justinladwig/Co2-Ampel/README.md

# Co2-Ampel

Ein Projekt von Dr. Dieter Bergmann, Justin Ladwig, Nico Meyer, Lars Wittenbrink, Maximilian Zopp.

Mit Unterstützung durch Dr. Meike Rix und Menze.
