justinladwig/Co2-Ampel/hardware/Kabelliste.pdf

Produkt | Bauteil | Pin | verbunden mit | Länge | Farbe
Kabel (0,6mm²) | Piezo | GND | GND links mitte | 4cm | schwarz
Kabel (0,6mm²) | Piezo | 3V | D7 | 8cm | weiß
Schrumpfschlauch | Piezo | | | 1cm | schwarz
Schrumpfschlauch | Piezo | | | 1cm | schwarz
Kabel (0,6mm²) | LED1 | 5V | VU | 7cm | rot
Kabel (0,6mm²) | LED1 | GND | GND links oben | 7cm | schwarz
Kabel (0,6mm²) | LED1 | DATA | D6 | 7cm | gelb
Kabel (0,6mm²) | LED2 | 5V | LED1 5V | 9cm | rot
Kabel (0,6mm²) | LED2 | GND | LED1 GND | 9cm | schwarz
Kabel (0,6mm²) | LED2 | DATA | LED1 DATA | 9cm | gelb
Kabel (0,6mm²) | Sensor | 3V | 3V rechts oben | 7cm | rot
Kabel (0,6mm²) | Sensor | GND | GND rechts oben | 7cm | schwarz
Kabel (0,6mm²) | Sensor | SCL | D1 | 7cm | gelb
Kabel (0,6mm²) | Sensor | SDA | D2 | 7cm | gelb
Kabel (0,6mm²) | Sensor | WAKE | D5 | 9cm | weiß
