justinladwig/Co2-Ampel/hardware/CO2 Melder - Preisliste.xlsx

Produkt | Shop | Info | Einzelpreis | Anzahl | Preis
AZDelivery 5 x NodeMCU Lua Lolin V3 (https://www.amazon.de/gp/product/B07Z69WT62/ref=ox_sc_act_title_1?smid=A1X7QLRQH87QA3&psc=1) | Amazon |  | 19.49 € | 2 | 38.98 €
Kuman 100pcs SK6812 (https://www.amazon.de/gp/product/B01M6WVCW3/ref=ox_sc_act_title_2?smid=A88IN2Y8YWCG3&psc=1) | Amazon |  | 21.99 € | 1 | 21.99 €
JOY-IT Breakout-Board CCS811 (https://www.pollin.de/p/joy-it-breakout-board-ccs811-zur-messung-der-luftreinheit-811051) | Pollin |  | 15.50 € | 10 | 155.00 €
Piezo-Schallwandler, Summer 3 V, 85 dB (https://www.pollin.de/p/piezo-schallwandler-summer-3-v-85-db-rm-5-08-piepsend-printmontage-390131) | Pollin |  | 0.44 € | 10 | 4.40 €
USB-Powerbank LogiLink PA0156, 2200 mAh (https://www.pollin.de/p/usb-powerbank-logilink-pa0156-2200-mah-1x-usb-port-schluesselanhaenger-272127) | Pollin |  | 1.99 € | 5 | 9.95 €
USB2.0 Kabel HAMA 176755, A/Micro-B, 0,2 m, 90° (https://www.pollin.de/p/usb2-0-kabel-hama-176755-a-micro-b-0-2-m-900-713578) | Pollin | nur für Powerbanks | 0.65 € | 5 | 3.25 €
Kabel für Netzteil (Nein) |  |  |  |  | 0.00 €
Acrylglas |  |  |  |  | 0.00 €
Schrauben |  |  |  |  | 0.00 €
Einschmelzmuttern |  |  |  |  | 0.00 €
 |  |  |  |  | 0.00 €
 |  |  |  |  | 0.00 €
 |  |  |  |  | 0.00 €
 |  |  |  |  | 0.00 €
 |  |  |  |  | 0.00 €
 |  |  |  |  | 0.00 €
 |  |  |  |  | 0.00 €
 |  |  |  |  | 0.00 €
 |  |  |  |  | 0.00 €
Ergebnis |  |  |  |  | 233.57 €
