justinladwig/Co2-Ampel/3D-Data/CO2 Case 80x80.stl

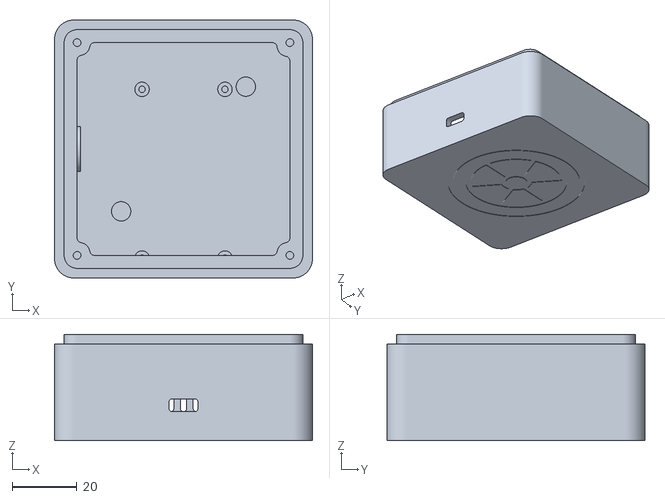
[picture p1: CAD file, 2020-12-04]
3D-Data/CO2 Case 80x80.stl
80.0 x 80.0 x 33.0
