justinladwig/Co2-Ampel/3D-Data/Gehaeuse 80x80 final 2.stl

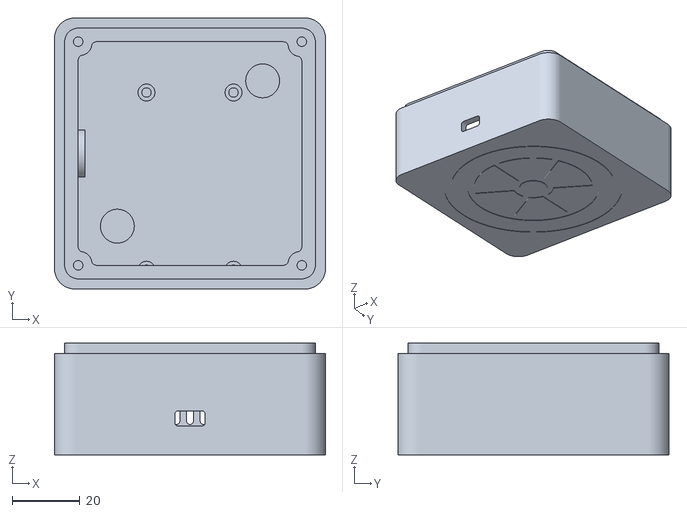
[picture p2: CAD file, 2020-12-04]
3D-Data/Gehaeuse 80x80 final 2.stl
80.0 x 80.0 x 33.0
