justinladwig/Co2-Ampel/3D-Data/Schrauben teststl.stl

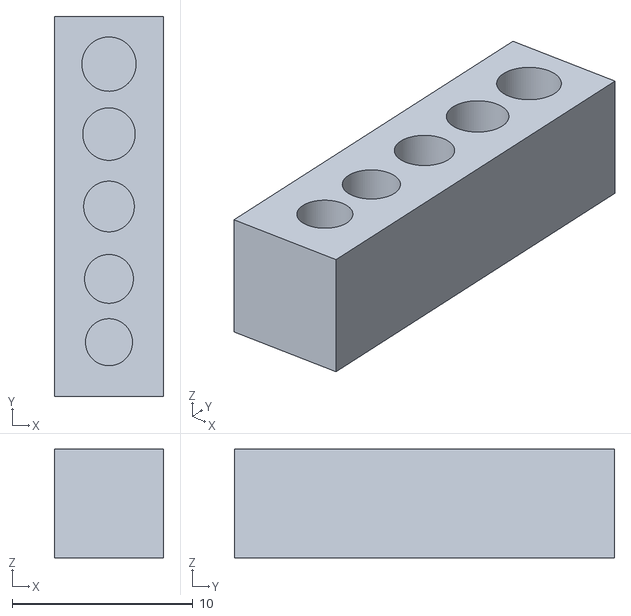
[picture p3: CAD file, 2020-12-04]
3D-Data/Schrauben teststl.stl
6.00 x 21.0 x 6.00
