justinladwig/Co2-Ampel/3D-Data/Plexi Glas Schablone 80x80.stl

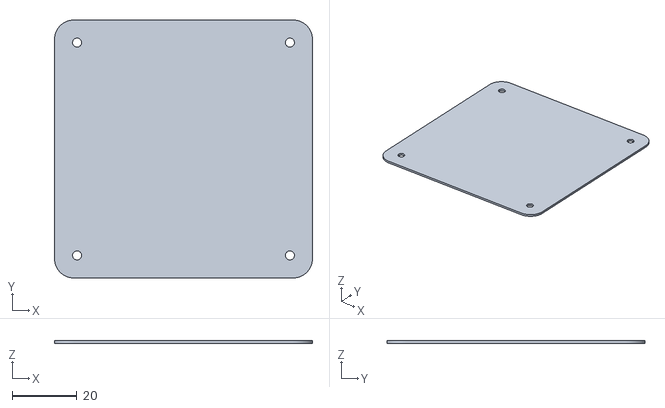
[picture p4: CAD file, 2020-12-04]
3D-Data/Plexi Glas Schablone 80x80.stl
80.0 x 80.0 x 0.8
