justinladwig/Co2-Ampel/3D-Data/Piezo Teststl.stl

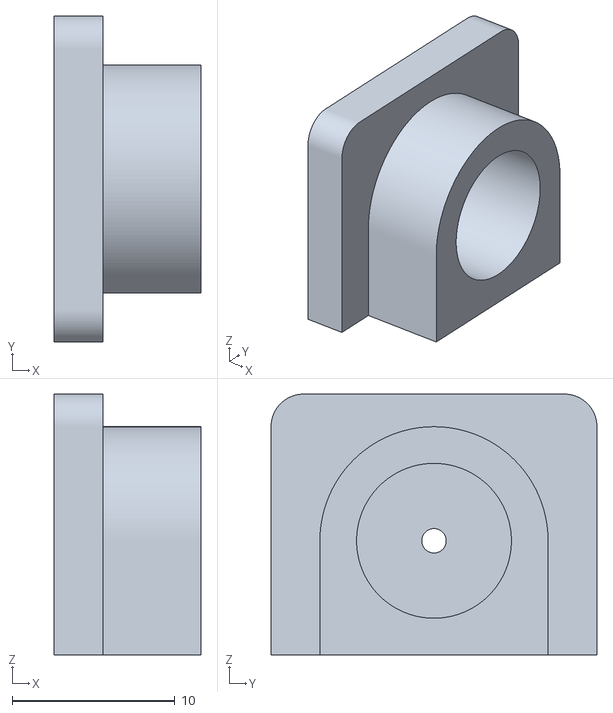
[picture p5: CAD file, 2020-12-04]
3D-Data/Piezo Teststl.stl
9.00 x 20.0 x 16.0
