justinladwig/Co2-Ampel/(list of files, cad)

Other CAD files:
3D-Data/Gehaeuse 80x80 final 3.stl
3D-Data/Gehaeuse 80x80 final.stl
3D-Data/CO2 Case 80x80 Nr. 2.stl
3D-Data/CO2 Melder RG Projekt 2 überarbeitung v13.step
3D-Data/Gehaeuse 80x80 final 4.stl
3D-Data/CO2 Melder RG Projekt 2 überarbeitung v13.f3d
