justinladwig/Co2-Ampel/hardware/CO2_Sensor_Steckplatine.pdf

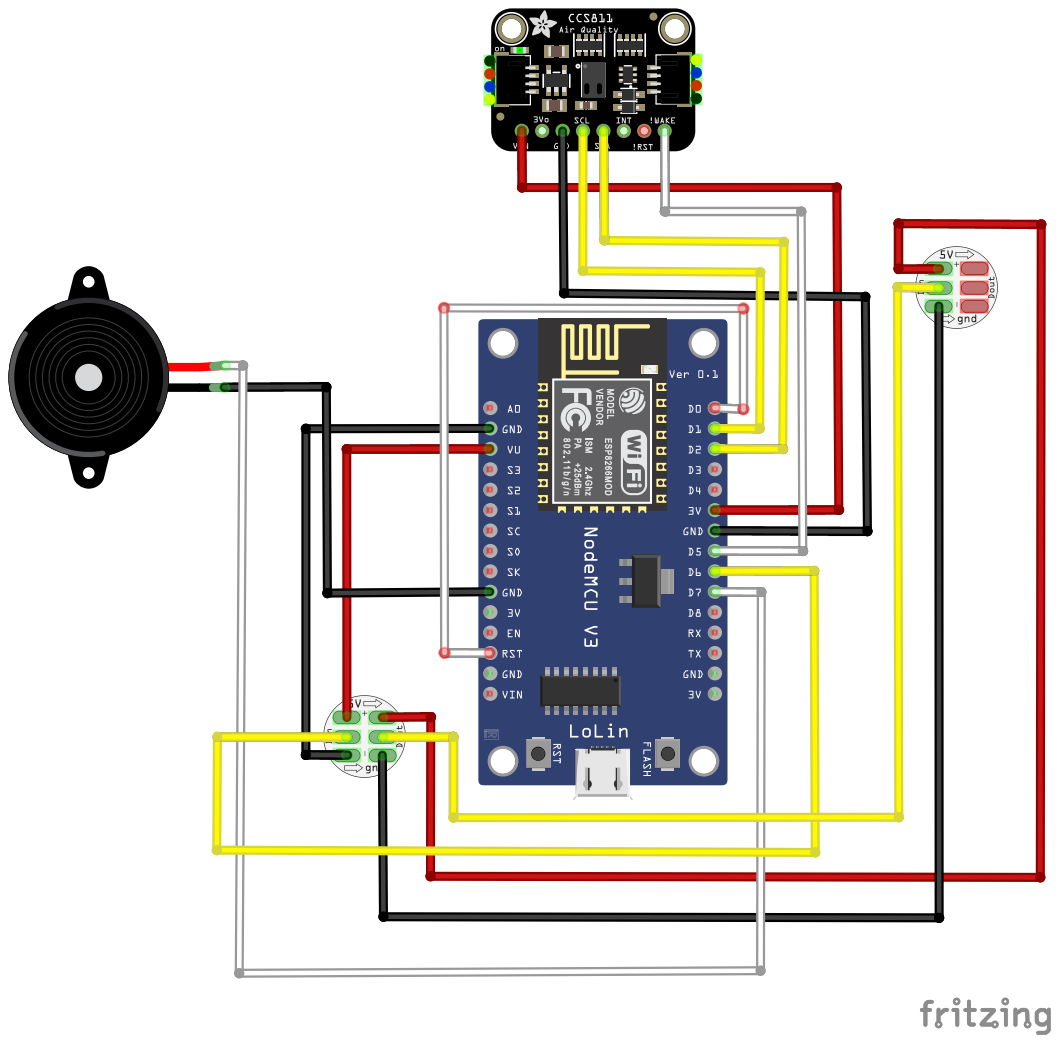
[picture p6: page 1]
