justinladwig/Co2-Ampel/3D-Data/CO2_Sensor_Steckplatine.pdf

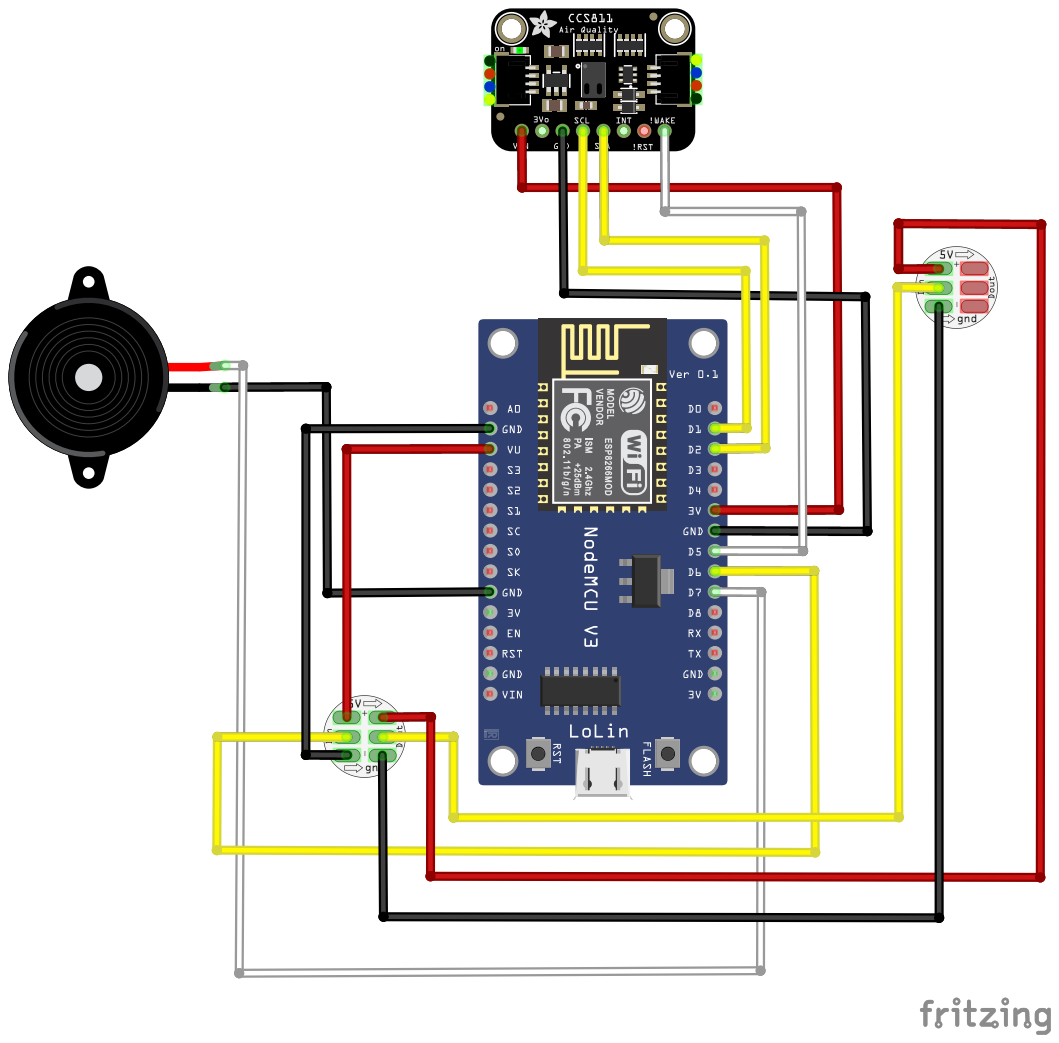
[picture p7: page 1]
