justinladwig/Co2-Ampel/(list of files, drawings)

Other design files:
hardware/CO2_Sensor.fzz
