justinladwig/Co2-Ampel/(commit log)

2020-12-01 add hardware files 1
    [CO2 Melder - Preisliste.xlsx, CO2_Sensor.fzz, Kabelliste.xlsx]
2020-12-01 add hardware file 2
    [CO2 Melder - Preisliste.xlsx, CO2_Sensor.fzz, Kabelliste.xlsx]
2020-12-02 Change arduino.json
2020-12-03 Add function to check sensor values.
2020-12-04 add 3D files
    [CO2 Case 80x80 Nr. 2.stl, CO2 Case 80x80.stl, CO2 Melder RG Projekt 2 überarbeitung v13.f3d, CO2 Melder RG Projekt 2 überarbeitung v13.step, Gehaeuse 80x80 final 2.stl, Gehaeuse 80x80 final 3.stl, Gehaeuse 80x80 final 4.stl, Gehaeuse 80x80 final.stl]
2020-12-06 Put Sensor in sleep mode and add thinkspeak example
2020-12-06 Correct includes andverify problems
    [Thinkspeak example.ino]
